Matthew-Bon/moon_child/rtls_board.DXF

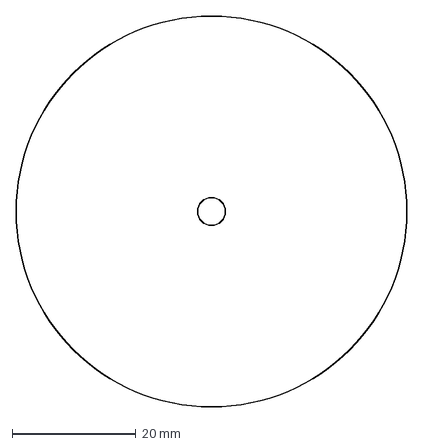
[picture p1: CAD file, 2024-12-01]
rtls_board.DXF
63.2 x 63.2 mm
