Matthew-Bon/moon_child/moon_child.kicad_pcb

## KiCad design moon_child.kicad_pcb (2025-09-13)

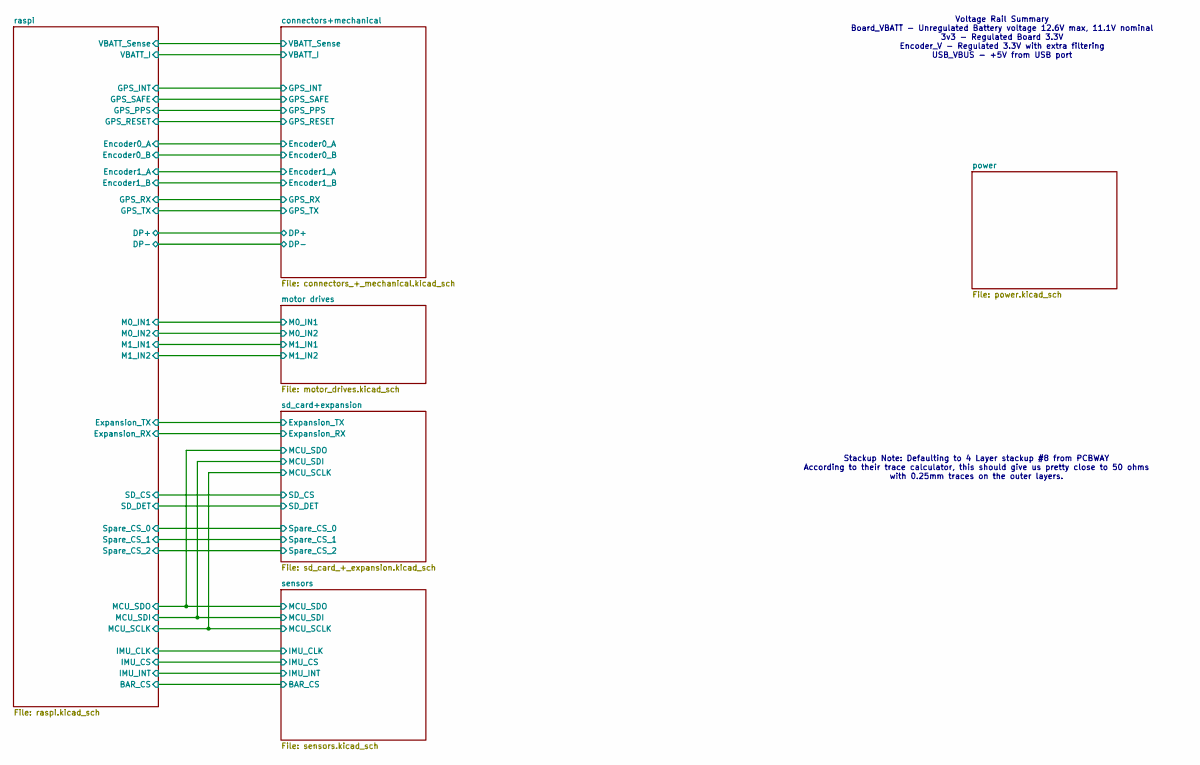
[picture p2: schematic moon_child.kicad_sch]

Notes on the sheet:
Voltage Rail Summary Board_VBATT - Unregulated Battery voltage 12.6V max, 11.1V nominal 3v3 - Regulated Board 3.3V Encoder_V - Regulated 3.3V with extra filtering USB_VBUS - +5V from USB port
Stackup Note: Defaulting to 4 Layer stackup #8 from PCBWAY According to their trace calculator, this should give us pretty close to 50 ohms with 0.25mm traces on the outer layers.

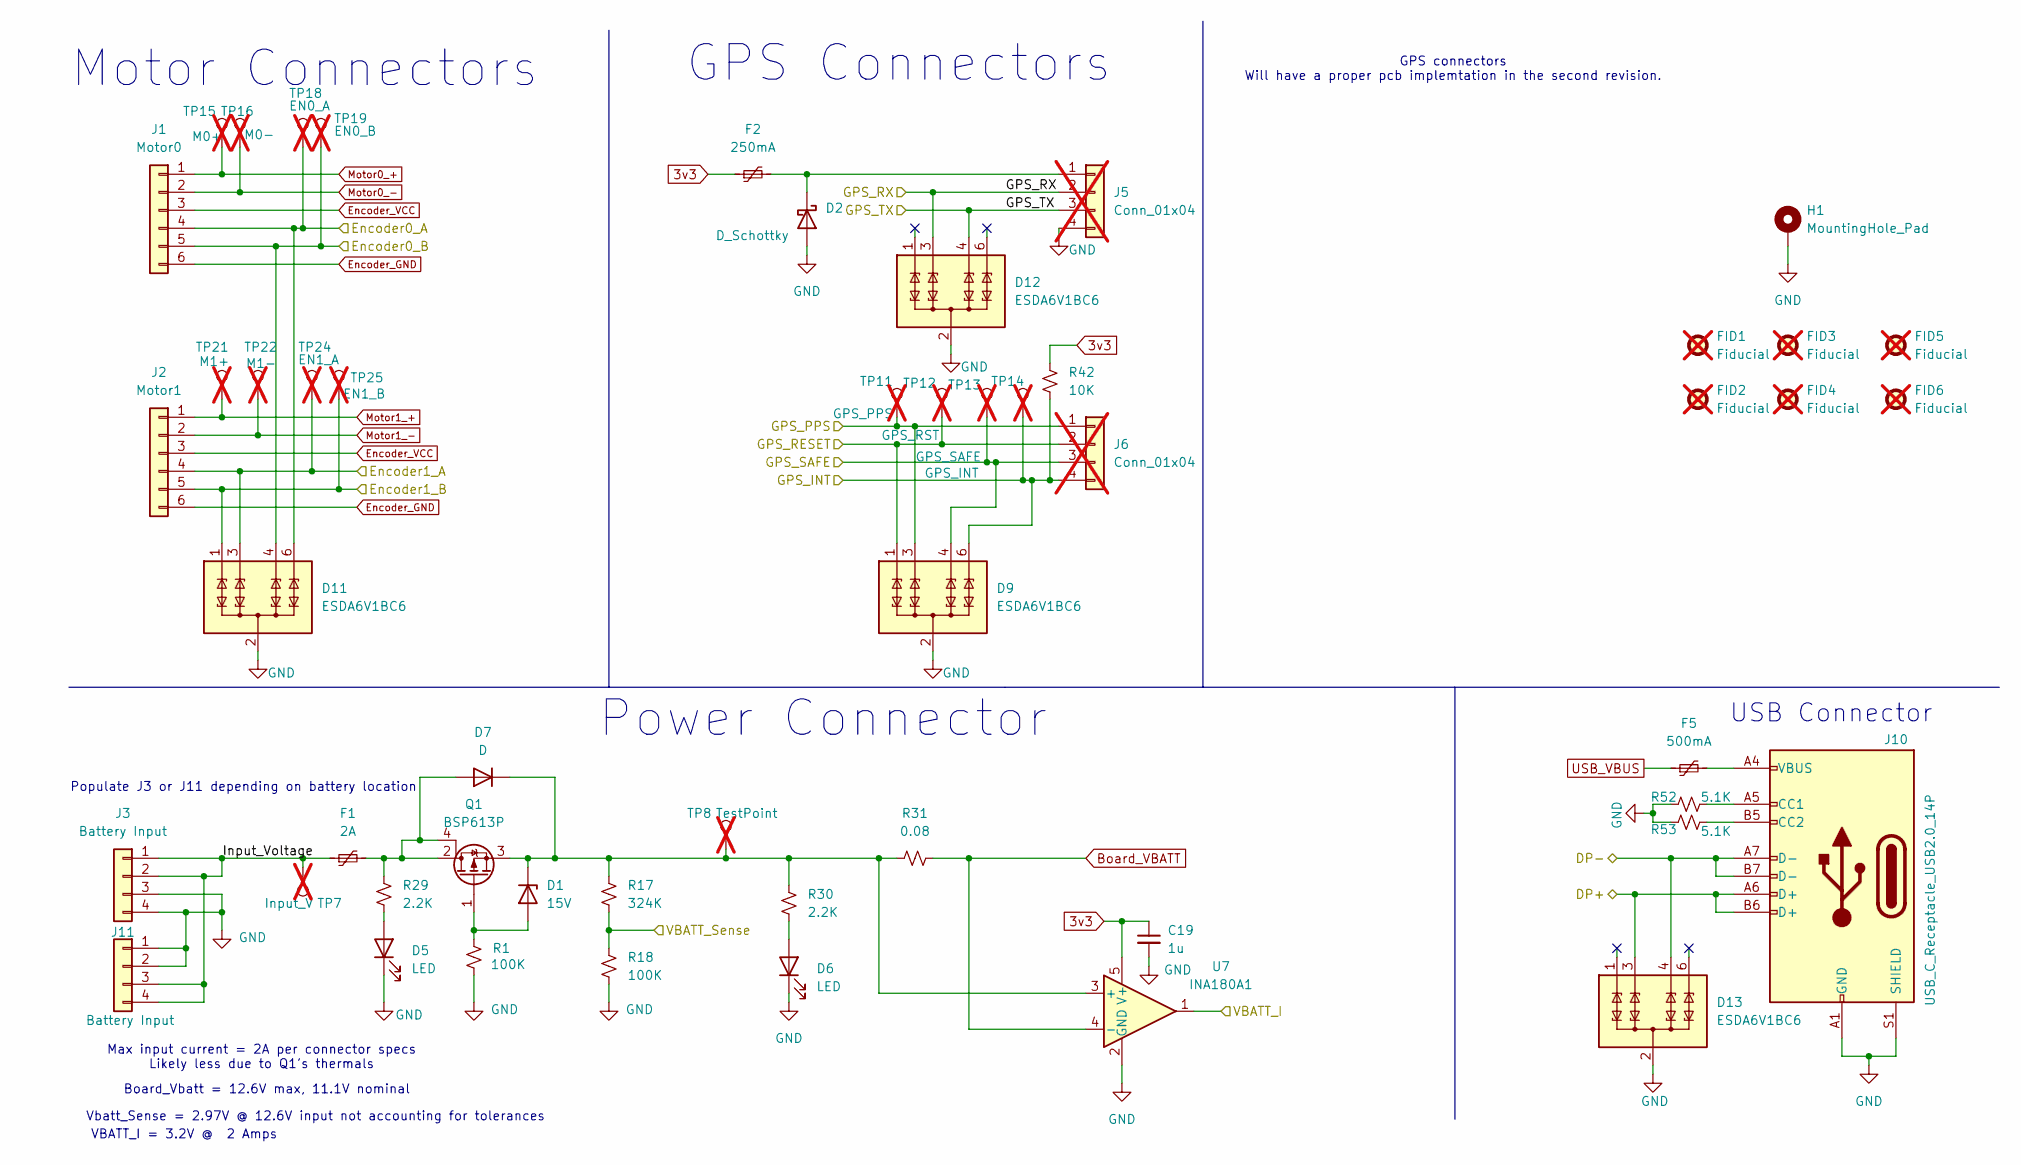
[picture p3: schematic connectors_+_mechanical.kicad_sch]

Parts:
C19: 1u; C_0603_1608Metric_Pad1.08x0.95mm_HandSolder; MPN CL10B105KP8NNNC
D1: 15V; D_SOD-323; MPN BZT52C15S-7-F
D2: D_Schottky; D_SOD-123; MPN MBR0530T1G
D5, D6: LED; D_0603_1608Metric_Pad1.05x0.95mm_HandSolder; MPN LTST-C190KFKT
D7: D; D_SMA; MPN S1J-13-F
D9, D11, D12, D13: ESDA6V1BC6; SOT-23-6; MPN ESDA6V1BC6
F1: 2A; Fuse_1206_3216Metric; MPN MF-NSML200/12-2
F2: 250mA; Fuse_1206_3216Metric; MPN 0ZCJ0025FF2E
F5: 500mA; Fuse_1206_3216Metric; MPN 0ZCJ0050AF2E
FID1, FID2, FID3, FID4, FID5, FID6: Fiducial; Fiducial_1mm_Mask2mm; not fitted
H1: MountingHole_Pad; MountingHole_4.3mm_M4_ISO14580_Pad
J1: Motor0; JST_SH_BM06B-SRSS-TB_1x06-1MP_P1.00mm_Vertical; MPN BM06B-SRSS-TB
J2: Motor1; JST_SH_BM06B-SRSS-TB_1x06-1MP_P1.00mm_Vertical; MPN BM06B-SRSS-TB
J3, J11: Battery Input; JST_SH_BM04B-SRSS-TB_1x04-1MP_P1.00mm_Vertical; MPN BM04B-SRSS-TB
J5, J6: Conn_01x04; PinHeader_1x04_P2.54mm_Vertical; not fitted
J10: USB_C_Receptacle_USB2.0_14P; GCT_USB4115-03-C_REVB4; MPN USB4115-03-C
Q1: BSP613P; SOT-223; MPN BSP613PH6327XTSA1
R1, R18: 100K; R_0402_1005Metric; MPN RC0402JR-07100KL
R17: 324K; R_0402_1005Metric; MPN RC0402FR-07324KL
R29, R30: 2.2K; R_0402_1005Metric; MPN RC0402JR-072K2L
R31: 0.08; R_1206_3216Metric; MPN RL1206FR-070R08L
R42: 10K; R_0402_1005Metric; MPN RC0402JR-0710KL
R52, R53: 5.1K; R_0402_1005Metric; MPN RC0402FR-075K1L
TP7: Input_V; TestPoint_Pad_D1.0mm; not fitted
TP8: TestPoint; TestPoint_Pad_D1.0mm; not fitted
TP11: GPS_PPS; TestPoint_Pad_D1.0mm; not fitted
TP12: GPS_RST; TestPoint_Pad_D1.0mm; not fitted
TP13: GPS_SAFE; TestPoint_Pad_D1.0mm; not fitted
TP14: GPS_INT; TestPoint_Pad_D1.0mm; not fitted
TP15: M0+; TestPoint_Pad_D1.0mm; not fitted
TP16: M0-; TestPoint_Pad_D1.0mm; not fitted
TP18: EN0_A; TestPoint_Pad_D1.0mm; not fitted
TP19: EN0_B; TestPoint_Pad_D1.0mm; not fitted
TP21: M1+; TestPoint_Pad_D1.0mm; not fitted
TP22: M1-; TestPoint_Pad_D1.0mm; not fitted
TP24: EN1_A; TestPoint_Pad_D1.0mm; not fitted
TP25: EN1_B; TestPoint_Pad_D1.0mm; not fitted
U7: INA180A1; SOT-23-5; MPN INA180A1IDBVR

Connections:
3v3: C19.1, F2.1, R42.1, U7.5 (V+); also elsewhere on the board
/connectors+mechanical/DP+: D13.3 (TVS2), J10.A6 (D+), J10.B6 (D+); also elsewhere on the board
/connectors+mechanical/DP-: D13.4 (TVS3), J10.A7 (D-), J10.B7 (D-); also elsewhere on the board
/connectors+mechanical/Encoder0_A: D11.6 (TVS4), J1.4, TP18.1; also elsewhere on the board
/connectors+mechanical/Encoder0_B: D11.4 (TVS3), J1.5, TP19.1; also elsewhere on the board
/connectors+mechanical/Encoder1_A: D11.3 (TVS2), J2.4, TP24.1; also elsewhere on the board
/connectors+mechanical/Encoder1_B: D11.1 (TVS1), J2.5, TP25.1; also elsewhere on the board
/connectors+mechanical/GPS_INT: D9.6 (TVS4), J6.4, R42.2, TP14.1; also elsewhere on the board
/connectors+mechanical/GPS_PPS: D9.3 (TVS2), J6.1, TP11.1; also elsewhere on the board
/connectors+mechanical/GPS_RESET: D9.1 (TVS1), J6.2, TP12.1; also elsewhere on the board
/connectors+mechanical/GPS_RX: D12.3 (TVS2), J5.2; also elsewhere on the board
/connectors+mechanical/GPS_SAFE: D9.4 (TVS3), J6.3, TP13.1; also elsewhere on the board
/connectors+mechanical/GPS_TX: D12.4 (TVS3), J5.3; also elsewhere on the board
/connectors+mechanical/Input_Voltage: F1.1, J3.1, J3.2, J11.3, J11.4, TP7.1
/connectors+mechanical/VBATT_I: U7.1; also elsewhere on the board
/connectors+mechanical/VBATT_Sense: R17.2, R18.1; also elsewhere on the board
Board_VBATT: R31.2, U7.4 (-); also elsewhere on the board
Encoder_GND: J1.6, J2.6; also elsewhere on the board
Encoder_VCC: J1.3, J2.3; also elsewhere on the board
GND: C19.2, D2.2 (A), D5.1 (K), D6.1 (K), D9.2 (COM), D9.5 (COM), D11.2 (COM), D11.5 (COM), D12.2 (COM), D12.5 (COM), D13.2 (COM), D13.5 (COM), H1.1, J3.3, J3.4, J5.4, J10.A1 (GND), J10.A12 (GND), J10.B1 (GND), J10.B12 (GND), J10.S1 (SHIELD), J11.1, J11.2, R1.2, R18.2, R52.1, R53.1, U7.2 (GND); also elsewhere on the board
Motor0_+: J1.1, TP15.1; also elsewhere on the board
Motor0_-: J1.2, TP16.1; also elsewhere on the board
Motor1_+: J2.1, TP21.1; also elsewhere on the board
Motor1_-: J2.2, TP22.1; also elsewhere on the board
unnamed: D1.2 (A), Q1.1 (G), R1.1
unnamed: D1.1 (K), D7.1 (K), Q1.3 (S), R17.1, R30.1, R31.1, TP8.1, U7.3 (+)
unnamed: D2.1 (K), F2.2, J5.1
unnamed: D5.2 (A), R29.2
unnamed: D6.2 (A), R30.2
unnamed: D7.2 (A), F1.2, Q1.2 (D), Q1.4 (D), R29.1
unnamed: F5.2, J10.A4 (VBUS), J10.A9 (VBUS), J10.B4 (VBUS), J10.B9 (VBUS)
unnamed: J10.A5 (CC1), R52.2
unnamed: J10.B5 (CC2), R53.2
USB_VBUS: F5.1; also elsewhere on the board

Notes on the sheet:
Populate J3 or J11 depending on battery location
Board_Vbatt = 12.6V max, 11.1V nominal
Motor Connectors
GPS Connectors
USB Connector
Vbatt_Sense = 2.97V @ 12.6V input not accounting for tolerances
GPS connectors Will have a proper pcb implemtation in the second revision.
VBATT_I = 3.2V @ 2 Amps
Power Connector
Max input current = 2A per connector specs Likely less due to Q1's thermals

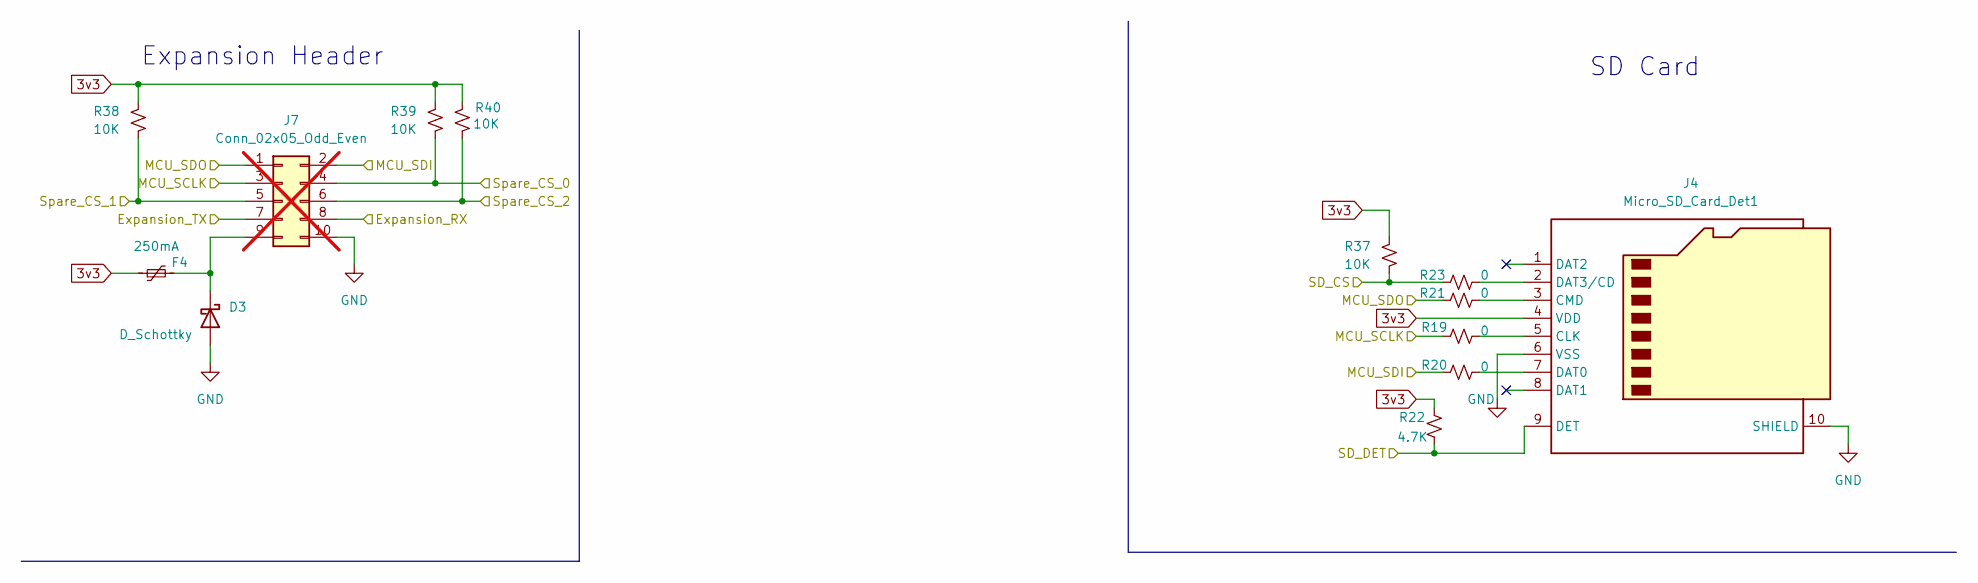
[picture p4: schematic sd_card_+_expansion.kicad_sch]

Parts:
D3: D_Schottky; D_SOD-123; MPN MBR0530T1G
F4: 250mA; Fuse_1206_3216Metric; MPN 0ZCJ0025FF2E
J4: Micro_SD_Card_Det1; microSD_HC_Hirose_DM3D-SF; MPN DM3D-SF
J7: Conn_02x05_Odd_Even; PinHeader_2x05_P2.54mm_Vertical_SMD; not fitted
R19, R20, R21, R23: 0; R_0402_1005Metric; MPN RC0402FR-070RL
R22: 4.7K; R_0402_1005Metric; MPN RC0402JR-074K7L
R37, R38, R39, R40: 10K; R_0402_1005Metric; MPN RC0402JR-0710KL

Connections:
3v3: F4.1, J4.4 (VDD), R22.1, R37.1, R38.1, R39.1, R40.1; also elsewhere on the board
/raspi/Expansion_RX: J7.8; also elsewhere on the board
/raspi/Expansion_TX: J7.7; also elsewhere on the board
/raspi/SD_CS: R23.1, R37.2; also elsewhere on the board
/raspi/SD_DET: J4.9 (DET), R22.2; also elsewhere on the board
/raspi/Spare_CS_0: J7.4, R39.2; also elsewhere on the board
/raspi/Spare_CS_1: J7.5, R38.2; also elsewhere on the board
/raspi/Spare_CS_2: J7.6, R40.2; also elsewhere on the board
/sensors/MCU_SCLK: J7.3, R19.1; also elsewhere on the board
/sensors/MCU_SDI: J7.2, R20.1; also elsewhere on the board
/sensors/MCU_SDO: J7.1, R21.1; also elsewhere on the board
GND: D3.2 (A), J4.6 (VSS), J4.10 (SHIELD), J7.10; also elsewhere on the board
unnamed: D3.1 (K), F4.2, J7.9
unnamed: J4.5 (CLK), R19.2
unnamed: J4.3 (CMD), R21.2
unnamed: J4.7 (DAT0), R20.2
unnamed: J4.2 (DAT3/CD), R23.2

Notes on the sheet:
Expansion Header
SD Card

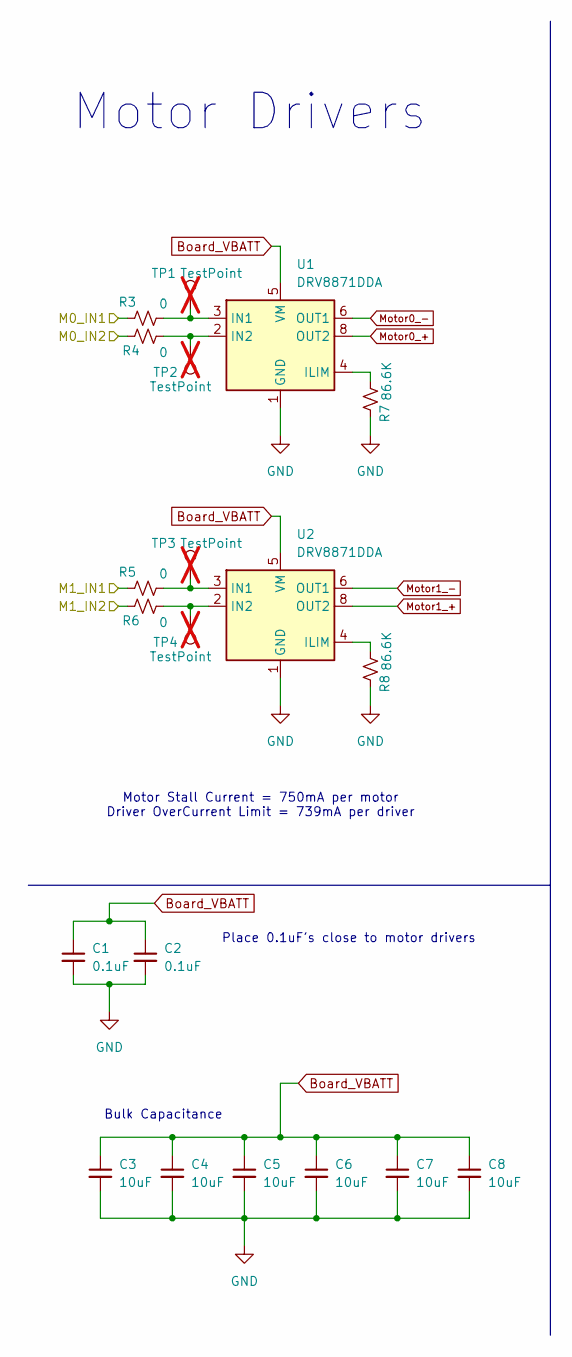
[picture p5: schematic motor_drives.kicad_sch]

Parts:
C1, C2: 0.1uF; C_0603_1608Metric_Pad1.08x0.95mm_HandSolder; MPN CC0603KRX7R7BB104
C3, C4, C5, C6, C7, C8: 10uF; C_0805_2012Metric_Pad1.18x1.45mm_HandSolder; MPN CL21A106KOQNNNE
R3, R4, R5, R6: 0; R_0402_1005Metric; MPN RC0402FR-070RL
R7, R8: 86.6K; R_0402_1005Metric; MPN CRCW040286K6FKEDC
TP1, TP2, TP3, TP4: TestPoint; TestPoint_Pad_D1.0mm; not fitted
U1, U2: DRV8871DDA; Texas_HTSOP-8-1EP_3.9x4.9mm_P1.27mm_EP2.95x4.9mm_Mask2.4x3.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; MPN DRV8871DDAR

Connections:
/motor drives/M0_IN1: R3.1; also elsewhere on the board
/motor drives/M0_IN2: R4.2; also elsewhere on the board
/motor drives/M1_IN1: R5.1; also elsewhere on the board
/motor drives/M1_IN2: R6.2; also elsewhere on the board
Board_VBATT: C1.1, C2.1, C3.1, C4.1, C5.1, C6.1, C7.1, C8.1, U1.5 (VM), U2.5 (VM); also elsewhere on the board
GND: C1.2, C2.2, C3.2, C4.2, C5.2, C6.2, C7.2, C8.2, R7.2, R8.2, U1.1 (GND), U1.7 (GND), U1.9 (GND), U2.1 (GND), U2.7 (GND), U2.9 (GND); also elsewhere on the board
Motor0_+: U1.8 (OUT2); also elsewhere on the board
Motor0_-: U1.6 (OUT1); also elsewhere on the board
Motor1_+: U2.8 (OUT2); also elsewhere on the board
Motor1_-: U2.6 (OUT1); also elsewhere on the board
unnamed: R7.1, U1.4 (ILIM)
unnamed: R3.2, TP1.1, U1.3 (IN1)
unnamed: R4.1, TP2.1, U1.2 (IN2)
unnamed: R8.1, U2.4 (ILIM)
unnamed: R5.2, TP3.1, U2.3 (IN1)
unnamed: R6.1, TP4.1, U2.2 (IN2)

Notes on the sheet:
Bulk Capacitance
Motor Drivers
Motor Stall Current = 750mA per motor Driver OverCurrent Limit = 739mA per driver
Place 0.1uF's close to motor drivers

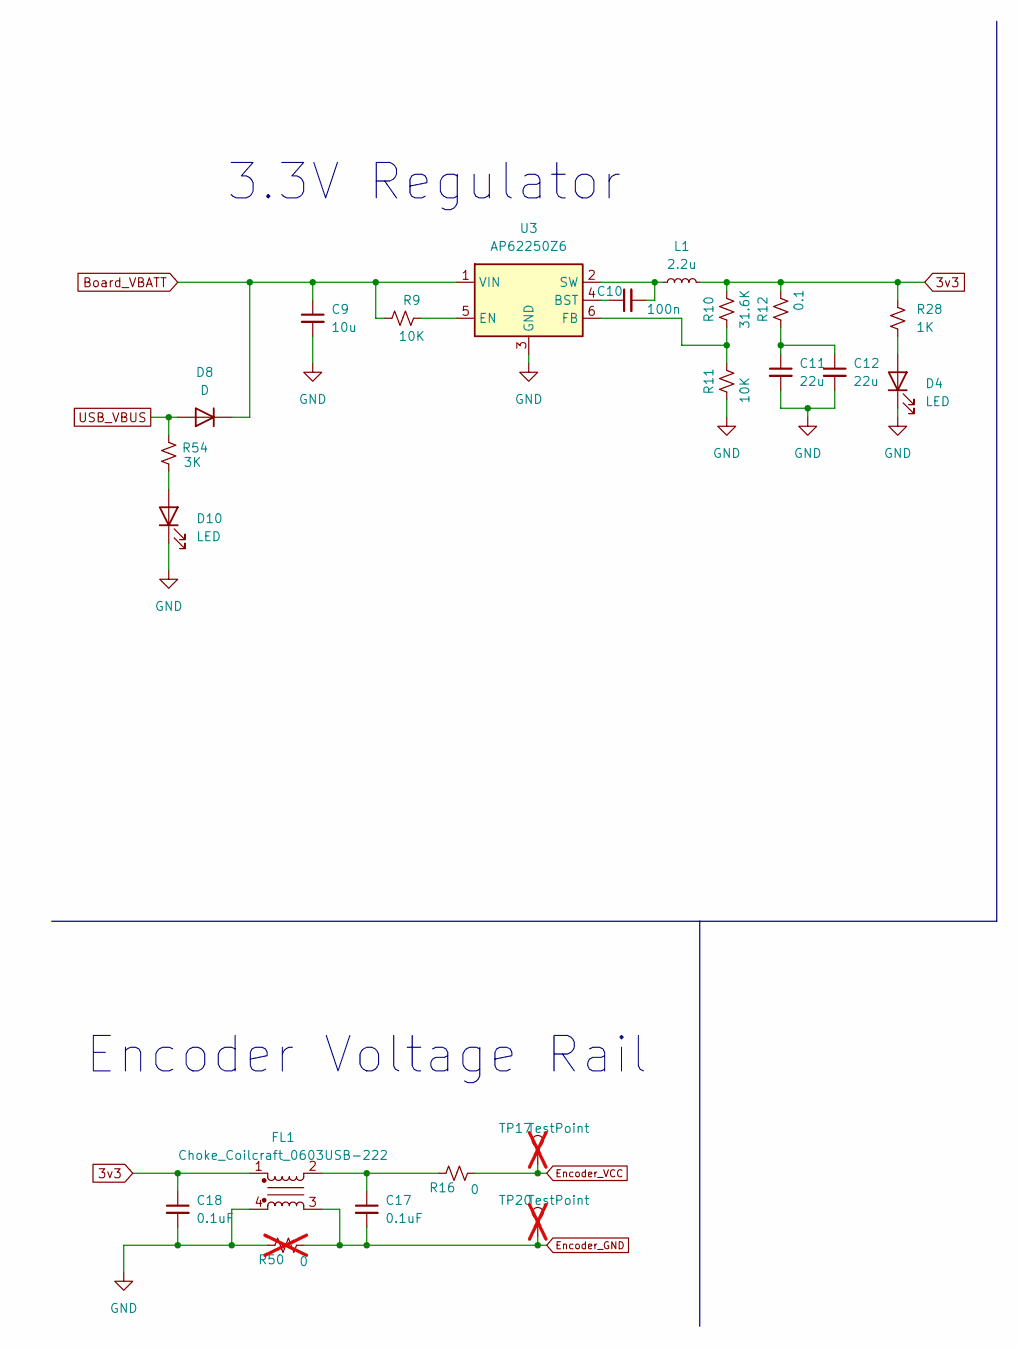
[picture p6: schematic power.kicad_sch]

Parts:
C9: 10u; C_0805_2012Metric; MPN CL21A106KOQNNNE
C10: 100n; C_0402_1005Metric; MPN CL05B104KP5NNNC
C11, C12: 22u; C_0805_2012Metric; MPN CL21A226MAYNNNE
C17, C18: 0.1uF; C_0603_1608Metric_Pad1.08x0.95mm_HandSolder; MPN CC0603KRX7R7BB104
D4, D10: LED; D_0603_1608Metric_Pad1.05x0.95mm_HandSolder; MPN LTST-C190KFKT
D8: D; D_SMA; MPN S1J-13-F
FL1: Choke_Coilcraft_0603USB-222; L_CommonModeChoke_Coilcraft_0603USB; MPN 0603USB-222MLC
L1: 2.2u; L_Bourns_SRP5030T; MPN SRP5030TA-2R2M
R9, R11: 10K; R_0402_1005Metric; MPN RC0402JR-0710KL
R10: 31.6K; R_0402_1005Metric; MPN RT0402FRE0731K6L
R12: 0.1; R_0805_2012Metric; MPN ERJ-6DSFR10V
R16: 0; R_0402_1005Metric; MPN RC0402FR-070RL
R28: 1K; R_0402_1005Metric; MPN RC0402JR-071KL
R50: 0; R_0402_1005Metric; MPN RC0402FR-070RL; not fitted
R54: 3K; R_0402_1005Metric; MPN ERA-2AEB302X
TP17, TP20: TestPoint; TestPoint_Pad_D1.0mm; not fitted
U3: AP62250Z6; SOT-563; MPN AP62250Z6-7

Connections:
3v3: C18.1, FL1.1, L1.2, R10.2, R12.2, R28.1; also elsewhere on the board
Board_VBATT: C9.1, D8.1 (K), R9.1, U3.1 (VIN); also elsewhere on the board
Encoder_GND: C17.2, FL1.3, R50.1, TP20.1; also elsewhere on the board
Encoder_VCC: R16.1, TP17.1; also elsewhere on the board
GND: C9.2, C11.2, C12.2, C18.2, D4.1 (K), D10.1 (K), FL1.4, R11.1, R50.2, U3.3 (GND); also elsewhere on the board
unnamed: C11.1, C12.1, R12.1
unnamed: C17.1, FL1.2, R16.2
unnamed: D4.2 (A), R28.2
unnamed: D10.2 (A), R54.2
unnamed: C10.1, U3.4 (BST)
unnamed: R9.2, U3.5 (EN)
unnamed: R10.1, R11.2, U3.6 (FB)
unnamed: C10.2, L1.1, U3.2 (SW)
USB_VBUS: D8.2 (A), R54.1; also elsewhere on the board

Notes on the sheet:
3.3V Regulator
Encoder Voltage Rail

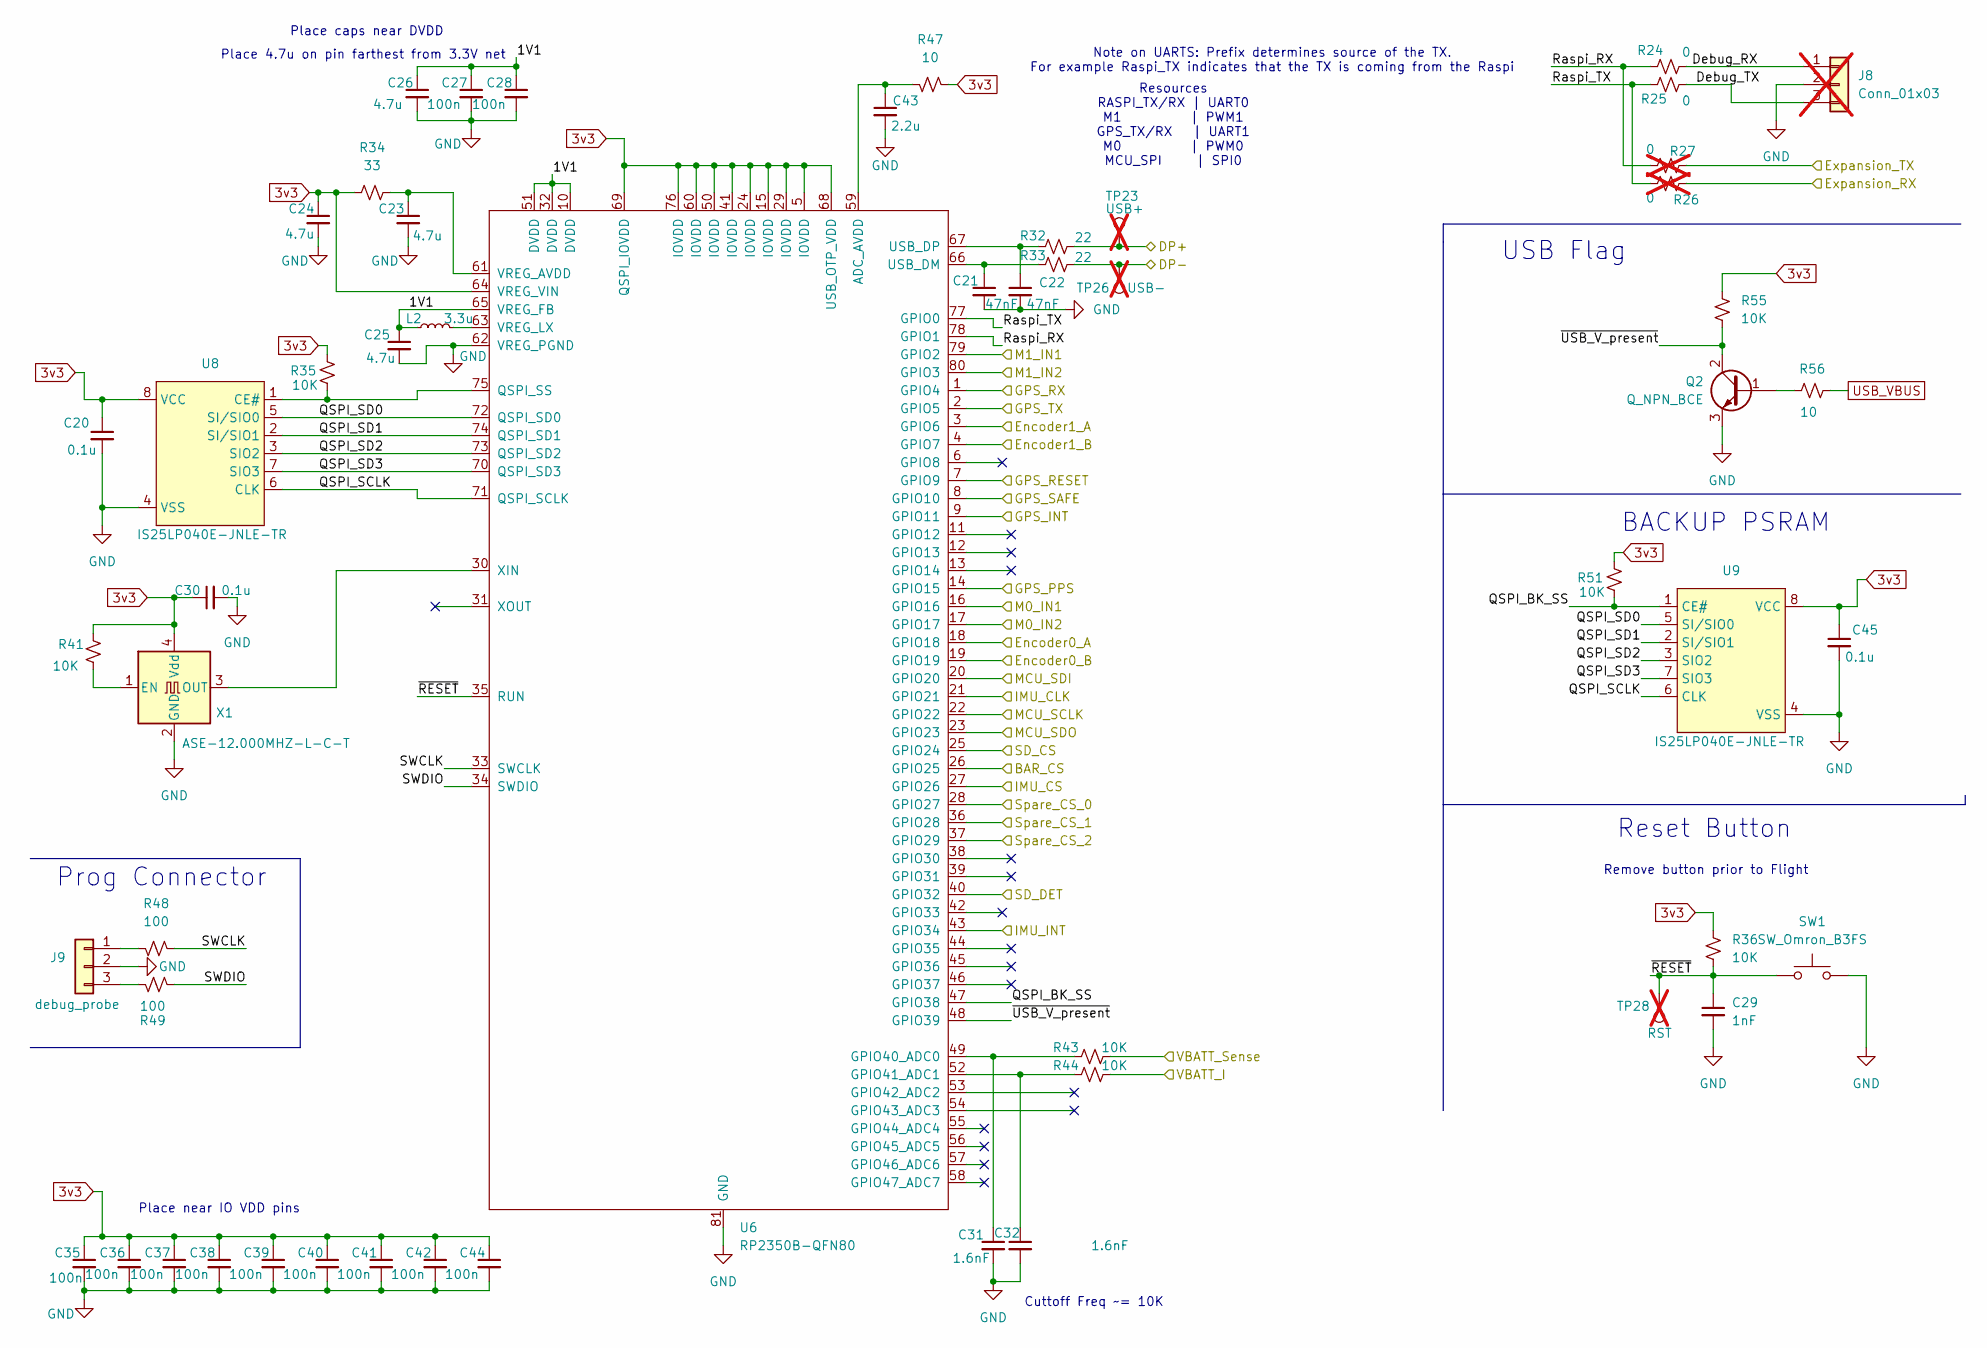
[picture p7: schematic raspi.kicad_sch]

Parts:
C20, C30, C45: 0.1u; C_0603_1608Metric_Pad1.08x0.95mm_HandSolder; MPN CC0603KRX7R7BB104
C21, C22: 47nF; C_0603_1608Metric_Pad1.08x0.95mm_HandSolder; MPN CL10B473KO8NNNC
C23, C24, C25, C26: 4.7u; C_0805_2012Metric_Pad1.18x1.45mm_HandSolder; MPN CL21A475KAQNNNE
C27, C28, C35, C36, C37, C38, C39, C40, C41, C42, C44: 100n; C_0603_1608Metric_Pad1.08x0.95mm_HandSolder; MPN CC0603KRX7R7BB104
C29: 1nF; C_0603_1608Metric_Pad1.08x0.95mm_HandSolder; MPN CL10B102KB8NNNC
C31, C32: 1.6nF; C_0603_1608Metric_Pad1.08x0.95mm_HandSolder; MPN GRM1885C1H162JA01D
C43: 2.2u; C_0603_1608Metric_Pad1.08x0.95mm_HandSolder; MPN CL10A225KO8NNNC
J8: Conn_01x03; PinHeader_1x03_P2.54mm_Vertical; not fitted
J9: debug_probe; JST_SH_BM03B-SRSS-TB_1x03-1MP_P1.00mm_Vertical; MPN BM03B-SRSS-TB
L2: 3.3u; L_1008_2520Metric; MPN TFM252012ALMA3R3MTAA
Q2: Q_NPN_BCE; SOT-23-3; MPN MMBT3904-7-F
R24, R25: 0; R_0402_1005Metric; MPN RC0402FR-070RL
R26, R27: 0; R_0402_1005Metric; MPN RC0402FR-070RL; not fitted
R32, R33: 22; R_0402_1005Metric; MPN RC0402FR-0722RL
R34: 33; R_0402_1005Metric; MPN RC0402JR-0733RL
R35, R36, R41, R43, R44, R51, R55: 10K; R_0402_1005Metric; MPN RC0402JR-0710KL
R47, R56: 10; R_0402_1005Metric; MPN RC0402FR-0710RL
R48, R49: 100; R_0402_1005Metric; MPN RC0402FR-07100RL
SW1: SW_Omron_B3FS; SW_SPST_B3S-1000; MPN B3FS-1002P
TP23: USB+; TestPoint_Pad_D1.0mm; not fitted
TP26: USB-; TestPoint_Pad_D1.0mm; not fitted
TP28: RST; TestPoint_Pad_D1.0mm; not fitted
U6: RP2350B-QFN80; RP2350B_QFN-80_EP_10.573x10.573_Pitch0.4mm; MPN SC1510-A4
U8, U9: IS25LP040E-JNLE-TR; SOIC-8_3.9x4.9mm_P1.27mm; MPN IS25LP040E-JNLE-TR
X1: ASE-12.000MHZ-L-C-T; Oscillator_SMD_Abracon_ASE-4Pin_3.2x2.5mm; MPN ASE-12.000MHZ-L-C-T

Connections:
3v3: C20.1, C24.1, C30.1, C35.1, C36.1, C37.1, C38.1, C39.1, C40.1, C41.1, C42.1, C44.1, C45.1, R34.1, R35.1, R36.1, R41.1, R47.1, R51.1, R55.1, U6.5 (IOVDD), U6.15 (IOVDD), U6.24 (IOVDD), U6.29 (IOVDD), U6.41 (IOVDD), U6.50 (IOVDD), U6.60 (IOVDD), U6.64 (VREG_VIN), U6.68 (USB_OTP_VDD), U6.69 (QSPI_IOVDD), U6.76 (IOVDD), U8.8 (VCC), U9.8 (VCC), X1.4 (Vdd); also elsewhere on the board
/connectors+mechanical/DP+: R32.2, TP23.1; also elsewhere on the board
/connectors+mechanical/DP-: R33.2, TP26.1; also elsewhere on the board
/connectors+mechanical/Encoder0_A: U6.18 (GPIO18); also elsewhere on the board
/connectors+mechanical/Encoder0_B: U6.19 (GPIO19); also elsewhere on the board
/connectors+mechanical/Encoder1_A: U6.3 (GPIO6); also elsewhere on the board
/connectors+mechanical/Encoder1_B: U6.4 (GPIO7); also elsewhere on the board
/connectors+mechanical/GPS_INT: U6.9 (GPIO11); also elsewhere on the board
/connectors+mechanical/GPS_PPS: U6.14 (GPIO15); also elsewhere on the board
/connectors+mechanical/GPS_RESET: U6.7 (GPIO9); also elsewhere on the board
/connectors+mechanical/GPS_RX: U6.1 (GPIO4); also elsewhere on the board
/connectors+mechanical/GPS_SAFE: U6.8 (GPIO10); also elsewhere on the board
/connectors+mechanical/GPS_TX: U6.2 (GPIO5); also elsewhere on the board
/connectors+mechanical/VBATT_I: R44.2; also elsewhere on the board
/connectors+mechanical/VBATT_Sense: R43.2; also elsewhere on the board
/motor drives/M0_IN1: U6.16 (GPIO16); also elsewhere on the board
/motor drives/M0_IN2: U6.17 (GPIO17); also elsewhere on the board
/motor drives/M1_IN1: U6.79 (GPIO2); also elsewhere on the board
/motor drives/M1_IN2: U6.80 (GPIO3); also elsewhere on the board
/raspi/1V1: C25.1, C26.1, C27.1, C28.1, L2.1, U6.10 (DVDD), U6.32 (DVDD), U6.51 (DVDD), U6.65 (VREG_FB)
/raspi/BAR_CS: U6.26 (GPIO25); also elsewhere on the board
/raspi/Debug_RX: J8.1, R24.2
/raspi/Debug_TX: J8.3, R25.1
/raspi/Expansion_RX: R26.1; also elsewhere on the board
/raspi/Expansion_TX: R27.2; also elsewhere on the board
/raspi/IMU_CLK: U6.21 (GPIO21); also elsewhere on the board
/raspi/IMU_CS: U6.27 (GPIO26); also elsewhere on the board
/raspi/IMU_INT: U6.43 (GPIO34); also elsewhere on the board
/raspi/QSPI_BK_SS: R51.2, U6.47 (GPIO38), U9.1 (CE#)
/raspi/QSPI_SCLK: U6.71 (QSPI_SCLK), U8.6 (CLK), U9.6 (CLK)
/raspi/QSPI_SD0: U6.72 (QSPI_SD0), U8.5 (SI/SIO0), U9.5 (SI/SIO0)
/raspi/QSPI_SD1: U6.74 (QSPI_SD1), U8.2 (SI/SIO1), U9.2 (SI/SIO1)
/raspi/QSPI_SD2: U6.73 (QSPI_SD2), U8.3 (SIO2), U9.3 (SIO2)
/raspi/QSPI_SD3: U6.70 (QSPI_SD3), U8.7 (SIO3), U9.7 (SIO3)
/raspi/Raspi_RX: R24.1, R27.1, U6.78 (GPIO1)
/raspi/Raspi_TX: R25.2, R26.2, U6.77 (GPIO0)
/raspi/SD_CS: U6.25 (GPIO24); also elsewhere on the board
/raspi/SD_DET: U6.40 (GPIO32); also elsewhere on the board
/raspi/SWCLK: R48.1, U6.33 (SWCLK)
/raspi/SWDIO: R49.1, U6.34 (SWDIO)
/raspi/Spare_CS_0: U6.28 (GPIO27); also elsewhere on the board
/raspi/Spare_CS_1: U6.36 (GPIO28); also elsewhere on the board
/raspi/Spare_CS_2: U6.37 (GPIO29); also elsewhere on the board
/raspi/~RESET: C29.1, R36.2, SW1.1, TP28.1, U6.35 (RUN)
/raspi/~USB_V_present: Q2.2 (C), R55.2, U6.48 (GPIO39)
/sensors/MCU_SCLK: U6.22 (GPIO22); also elsewhere on the board
/sensors/MCU_SDI: U6.20 (GPIO20); also elsewhere on the board
/sensors/MCU_SDO: U6.23 (GPIO23); also elsewhere on the board
GND: C20.2, C21.2, C22.2, C23.2, C24.2, C25.2, C26.2, C27.2, C28.2, C29.2, C30.2, C31.2, C32.2, C35.2, C36.2, C37.2, C38.2, C39.2, C40.2, C41.2, C42.2, C43.2, C44.2, C45.2, J8.2, J9.2, Q2.3 (E), SW1.2, U6.62 (VREG_PGND), U6.81 (GND), U8.4 (VSS), U9.4 (VSS), X1.2 (GND); also elsewhere on the board
unnamed: J9.1, R48.2
unnamed: J9.3, R49.2
unnamed: Q2.1 (B), R56.1
unnamed: C43.1, R47.2, U6.59 (ADC_AVDD)
unnamed: C31.1, R43.1, U6.49 (GPIO40_ADC0)
unnamed: C32.1, R44.1, U6.52 (GPIO41_ADC1)
unnamed: R35.2, U6.75 (QSPI_SS), U8.1 (CE#)
unnamed: C21.1, R33.1, U6.66 (USB_DM)
unnamed: C22.1, R32.1, U6.67 (USB_DP)
unnamed: C23.1, R34.2, U6.61 (VREG_AVDD)
unnamed: L2.2, U6.63 (VREG_LX)
unnamed: U6.30 (XIN), X1.3 (OUT)
unnamed: R41.2, X1.1 (EN)
USB_VBUS: R56.2; also elsewhere on the board

Notes on the sheet:
USB Flag
Place near IO VDD pins
Resources RASPI_TX/RX | UART0 M1 | PWM1 GPS_TX/RX | UART1 M0 | PWM0 MCU_SPI | SPI0
Note on UARTS: Prefix determines source of the TX. For example Raspi_TX indicates that the TX is coming from the Raspi
Reset Button
Cuttoff Freq ~= 10K
Remove button prior to Flight
BACKUP PSRAM
Place 4.7u on pin farthest from 3.3V net
Place caps near DVDD
Prog Connector

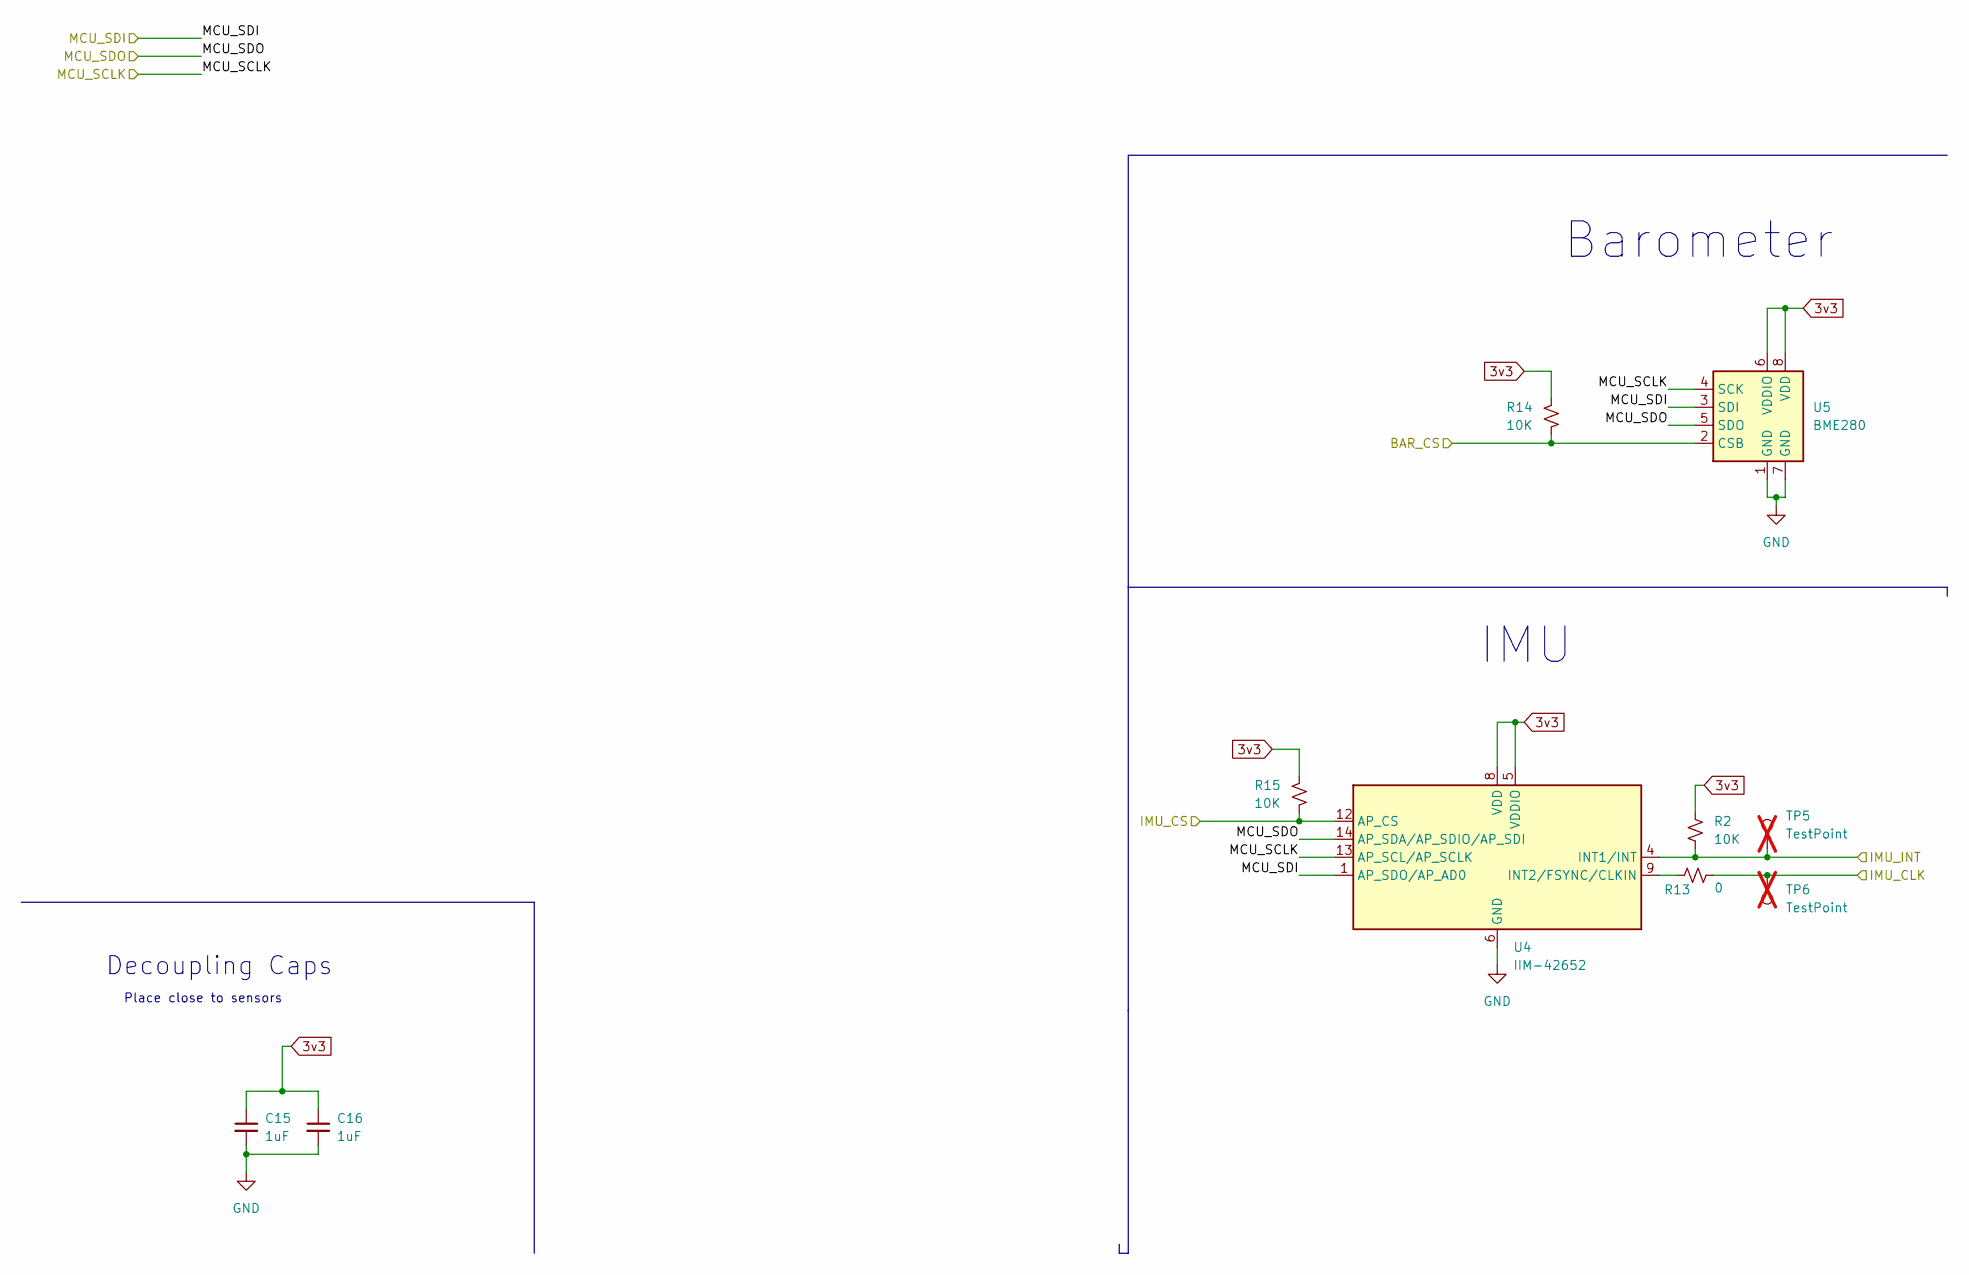
[picture p8: schematic sensors.kicad_sch]

Parts:
C15, C16: 1uF; C_0603_1608Metric_Pad1.08x0.95mm_HandSolder; MPN CL10B105KP8NNNC
R2, R14, R15: 10K; R_0402_1005Metric; MPN RC0402JR-0710KL
R13: 0; R_0402_1005Metric; MPN RC0402FR-070RL
TP5, TP6: TestPoint; TestPoint_Pad_D1.0mm; not fitted
U4: IIM-42652; Bosch_LGA-14_3x2.5mm_P0.5mm; MPN IIM-42652
U5: BME280; Bosch_LGA-8_2x2.5mm_P0.65mm_ClockwisePinNumbering; MPN BME280

Connections:
3v3: C15.1, C16.1, R2.1, R14.1, R15.1, U4.5 (VDDIO), U4.8 (VDD), U5.6 (VDDIO), U5.8 (VDD); also elsewhere on the board
/raspi/BAR_CS: R14.2, U5.2 (CSB); also elsewhere on the board
/raspi/IMU_CLK: R13.1, TP6.1; also elsewhere on the board
/raspi/IMU_CS: R15.2, U4.12 (AP_CS); also elsewhere on the board
/raspi/IMU_INT: R2.2, TP5.1, U4.4 (INT1/INT); also elsewhere on the board
/sensors/MCU_SCLK: U4.13 (AP_SCL/AP_SCLK), U5.4 (SCK); also elsewhere on the board
/sensors/MCU_SDI: U4.1 (AP_SDO/AP_AD0), U5.3 (SDI); also elsewhere on the board
/sensors/MCU_SDO: U4.14 (AP_SDA/AP_SDIO/AP_SDI), U5.5 (SDO); also elsewhere on the board
GND: C15.2, C16.2, U4.6 (GND), U4.7 (GND), U5.1 (GND), U5.7 (GND); also elsewhere on the board
unnamed: R13.2, U4.9 (INT2/FSYNC/CLKIN)

Notes on the sheet:
IMU
Decoupling Caps
Barometer
Place close to sensors
