Matthew-Bon/moon_child/moon_child.kicad_pcb

## KiCad design moon_child.kicad_pcb (continued)

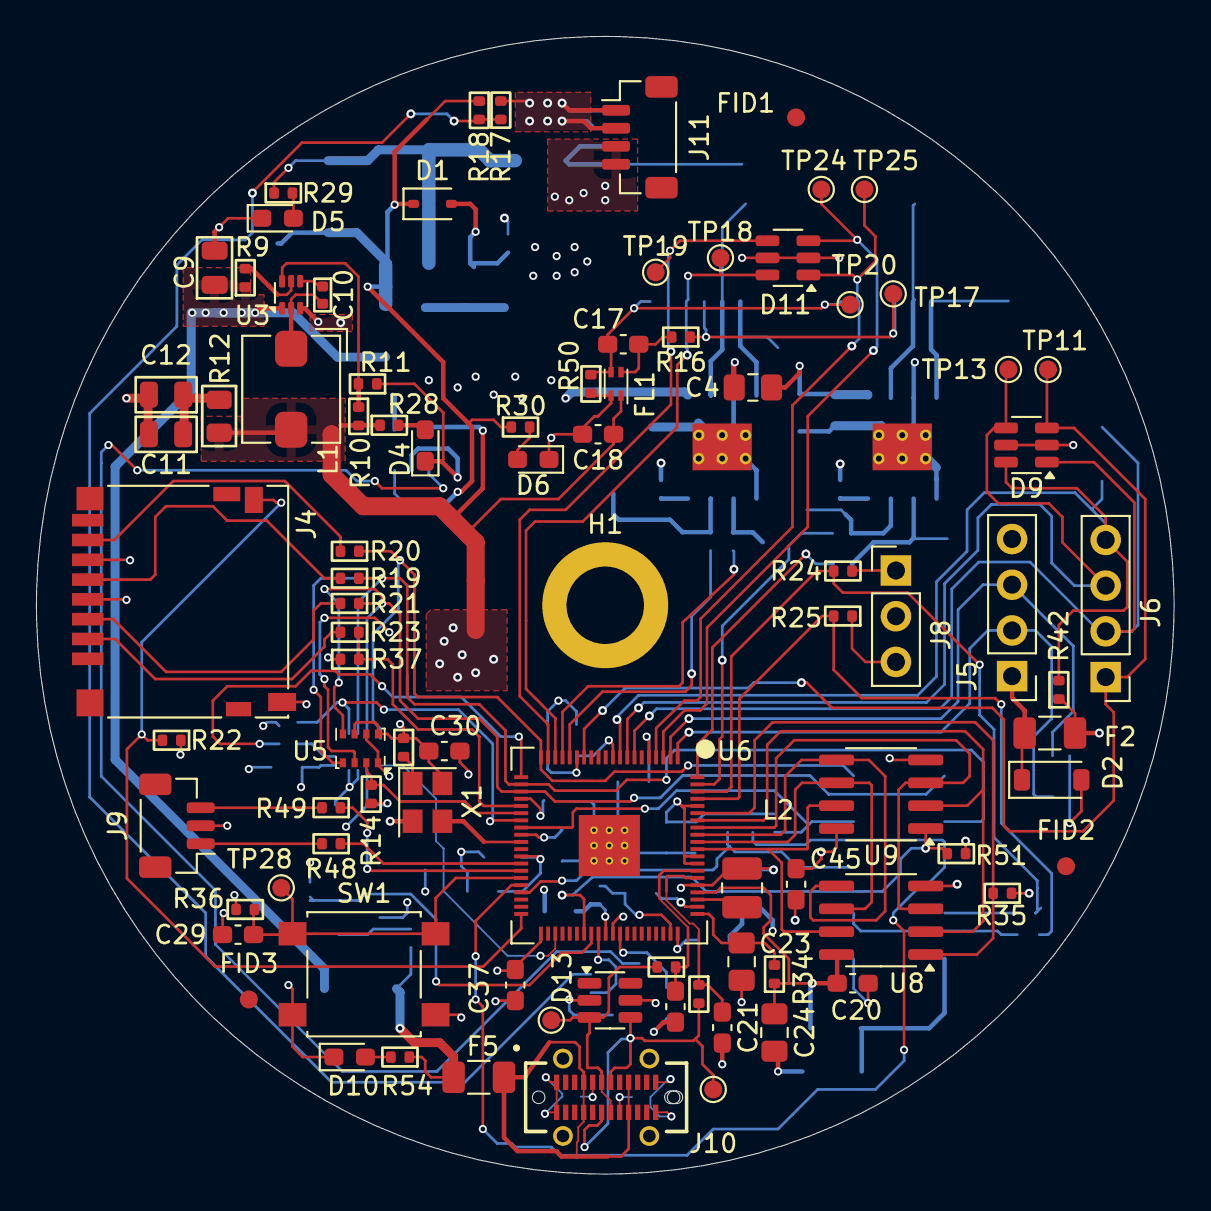
[picture p9: board moon_child.kicad_pcb from above]

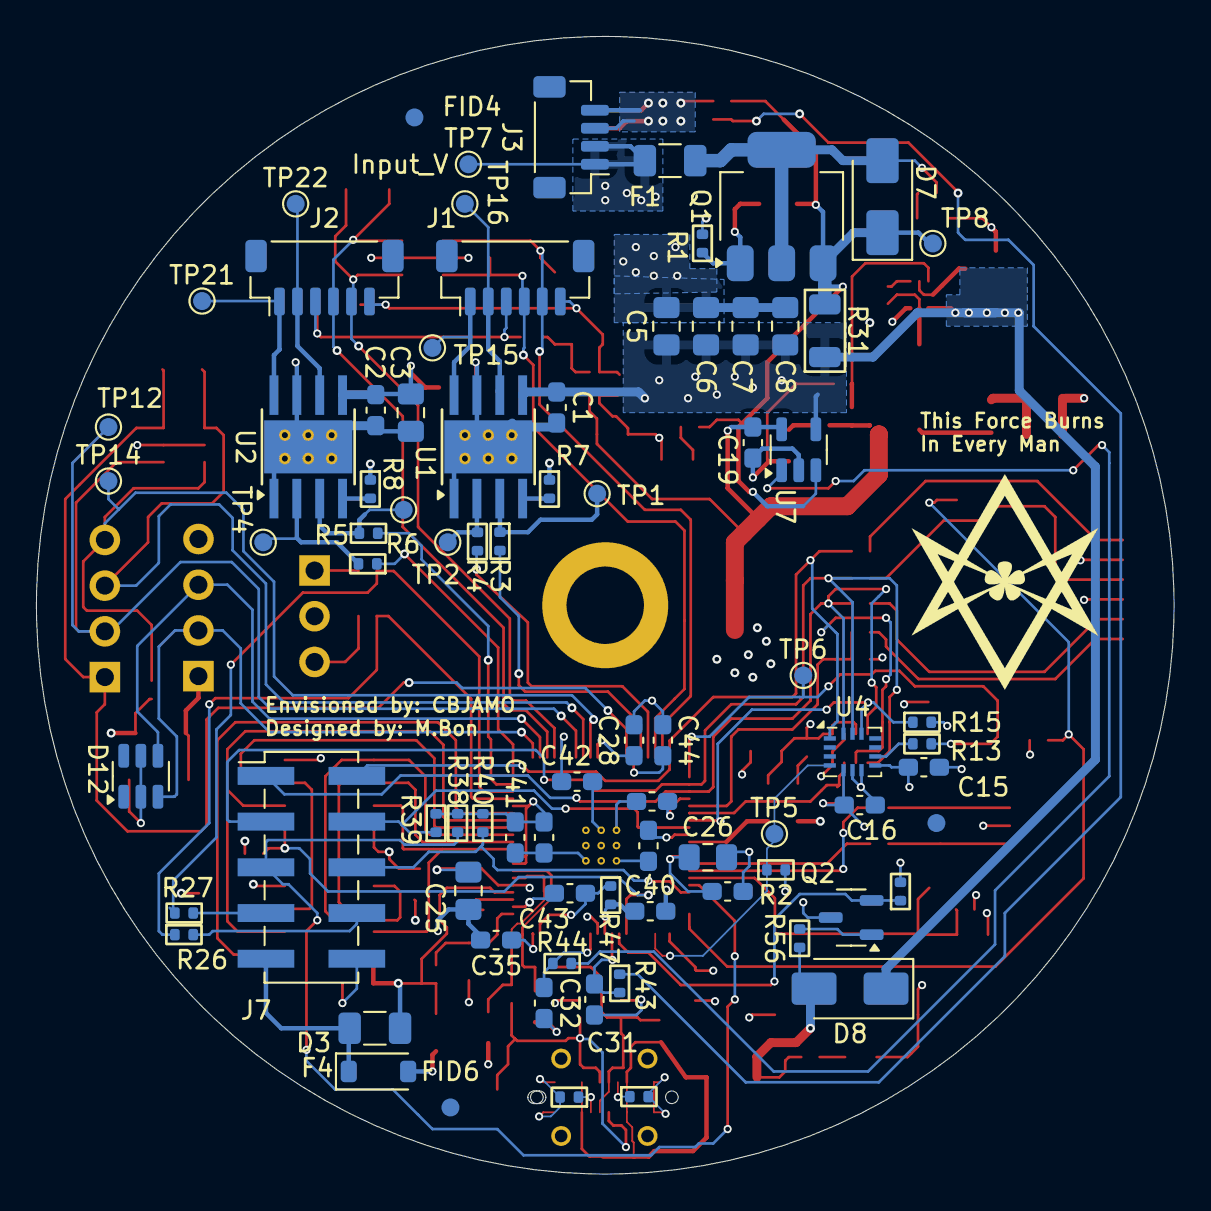
[picture p10: board moon_child.kicad_pcb from below]

Board: 4 copper layers, 63.2 x 63.2 mm, 171 parts (81 on the bottom side), 100 nets.
