Matthew-Bon/moon_child/(commit log)

2024-09-02 Added connectors
    Added GPS and SD card connections
    [connectors_+_mechanical.kicad_sch, sd_card_+_expansion.kicad_sch]
2024-09-03 Updated schematics
    Added the input current sense, expansion header and various test points.
    [connectors_+_mechanical.kicad_sch, motor_drives.kicad_sch, power.kicad_sch, raspi.kicad_sch, sd_card_+_expansion.kicad_sch]
2024-09-08 Added RPI stuff
    Added power passives and usb passives
    [power.kicad_sch, raspi.kicad_sch, sd_card_+_expansion.kicad_sch]
2024-09-08 Setup top sheet
    Added TVS diodes, updated top sheet, misc label fixes
    [connectors_+_mechanical.kicad_sch, moon_child.kicad_sch, motor_drives.kicad_sch, raspi.kicad_sch, sd_card_+_expansion.kicad_sch, sensors.kicad_sch]
2024-09-08 Updated Raspi Sheet
    Added hierarchical labels and misc additions.
    [raspi.kicad_sch]
2024-11-24 Updated MCU pinout
    Added bypass caps and started assigning pinouts.
    [connectors_+_mechanical.kicad_sch, raspi.kicad_sch]
2024-11-24 Finnished pinouts
    pending input from firmware
    [raspi.kicad_sch]
2024-11-24 Updated sheet to sheet pinout
    Updated pinouts and cleared ERCs
    [moon_child.kicad_sch, power.kicad_sch, raspi.kicad_sch, sd_card_+_expansion.kicad_sch]
2024-12-01 started layout
    Preliminary footprint selection
    [connectors_+_mechanical.kicad_sch, moon_child.kicad_pcb, motor_drives.kicad_sch, power.kicad_sch, raspi.kicad_sch, sd_card_+_expansion.kicad_sch, sensors.kicad_sch]
2024-12-01 footprint cleanup
    switched to 0402 resistors, updated connectors, etc...
    [connectors_+_mechanical.kicad_sch, moon_child.kicad_pcb, motor_drives.kicad_sch, power.kicad_sch, raspi.kicad_sch, rtls_board.DXF, sd_card_+_expansion.kicad_sch, sensors.kicad_sch]
2024-12-01 Added USB C Connector
    Added usb C connector, consolidated ESD parts, cleaned up footprint selection.
    [connectors_+_mechanical.kicad_sch, moon_child.kicad_pcb, moon_child.kicad_sch, power.kicad_sch, raspi.kicad_sch]
2024-12-02 Updated layout
    Added ground fills, updated stackup, added notes.
    [moon_child.kicad_pcb, moon_child.kicad_sch]
2024-12-29 Swapped USB to Vert
    Changed USB-C connector from horizontal to vertical
    [connectors_+_mechanical.kicad_sch, moon_child.kicad_pcb]
2024-12-29 Swapped motor polarity
    Swapped motor polarity for easier routing + other component positioning.
    [moon_child.kicad_pcb, motor_drives.kicad_sch]
2024-12-29 Updated routing
    [moon_child.kicad_pcb]
2025-01-20 Layout updates
    Added 3v3 switcher layout + extras
    [connectors_+_mechanical.kicad_sch, moon_child.kicad_pcb]
2025-01-20 QSPI routing
    Added pretty sub-optimal qspi routing
    [moon_child.kicad_pcb]
2025-01-21 GPS layout
    Routed gps and motor control connections
    [moon_child.kicad_pcb]
2025-01-25 Moved passives
    Lots passive routing
    [moon_child.kicad_pcb]
2025-01-25 Distributed caps
    Remembered to add decoupling caps
    [moon_child.kicad_pcb, sd_card_+_expansion.kicad_sch]
2025-01-25 imu routing
    updates to imu routes
    [moon_child.kicad_pcb]
2025-01-25 USB routing
    Updated usb routing
    [moon_child.kicad_pcb]
2025-03-16 Updates
    Routing updates, placed expansion connector.
    [connectors_+_mechanical.kicad_sch, moon_child.kicad_pcb, sd_card_+_expansion.kicad_sch, sensors.kicad_sch]
2025-03-16 more routing updates
    [moon_child.kicad_pcb]
2025-04-20 layout updates
    Updated encoder, esd and other layouts
    [connectors_+_mechanical.kicad_sch, moon_child.kicad_pcb, power.kicad_sch]
2025-05-17 Layout updates
    testpoints, usb power, etc.
    [connectors_+_mechanical.kicad_sch, moon_child.kicad_pcb, motor_drives.kicad_sch, power.kicad_sch, raspi.kicad_sch, sensors.kicad_sch]
2025-05-17 layout updates
    removes ADC 2 and ADC 3 connections for space reasons
    [connectors_+_mechanical.kicad_sch, moon_child.kicad_pcb, raspi.kicad_sch]
2025-05-17 layout updates
    SPI routes
    [moon_child.kicad_pcb, raspi.kicad_sch]
2025-05-17 Routing updates
    All nets connected, still need to clear DRCS and fix silks
    [moon_child.kicad_pcb]
2025-07-06 silkscreen cleanup
    Cleaned up silks
    [moon_child.kicad_pcb]
2025-08-16 silk fixes
    [moon_child.kicad_pcb]
2025-09-01 CBjamo updats
    Added J11 to accommodate batteries on both sides and changed pinout of J8 to have ground in the middle.
    [connectors_+_mechanical.kicad_sch, moon_child.kicad_pcb, raspi.kicad_sch]
2025-09-01 swapped J8 pinout
    [moon_child.kicad_pcb]
2025-09-01 silk cleanup
    Updated PSRAM value to use a flash PN, Updated 0402 footprints to give more room between pads and silkscreen. cleaned up overlaps.
    [moon_child.kicad_pcb, raspi.kicad_sch]
2025-09-01 More silk fixes
    More silk fixes
    [moon_child.kicad_pcb]
2025-09-13 layout cleanup
    increased some trace spaces for manufacturability. Cleaned up drc by ignoring pad rule.
    [moon_child.kicad_pcb]
2025-09-13 Bom updates
    [connectors_+_mechanical.kicad_sch, motor_drives.kicad_sch, power.kicad_sch, raspi.kicad_sch, sd_card_+_expansion.kicad_sch, sensors.kicad_sch]
2025-09-13 Launch day
    Completed BOM, added silk art
    [connectors_+_mechanical.kicad_sch, moon_child.kicad_pcb, power.kicad_sch, raspi.kicad_sch, sd_card_+_expansion.kicad_sch]
